HarmonInstruments/thelio-io-hardware/pcb-thelio-io/thelio-io.kicad_sch

## KiCad design pcb-thelio-io/thelio-io.kicad_sch (2023-07-17)

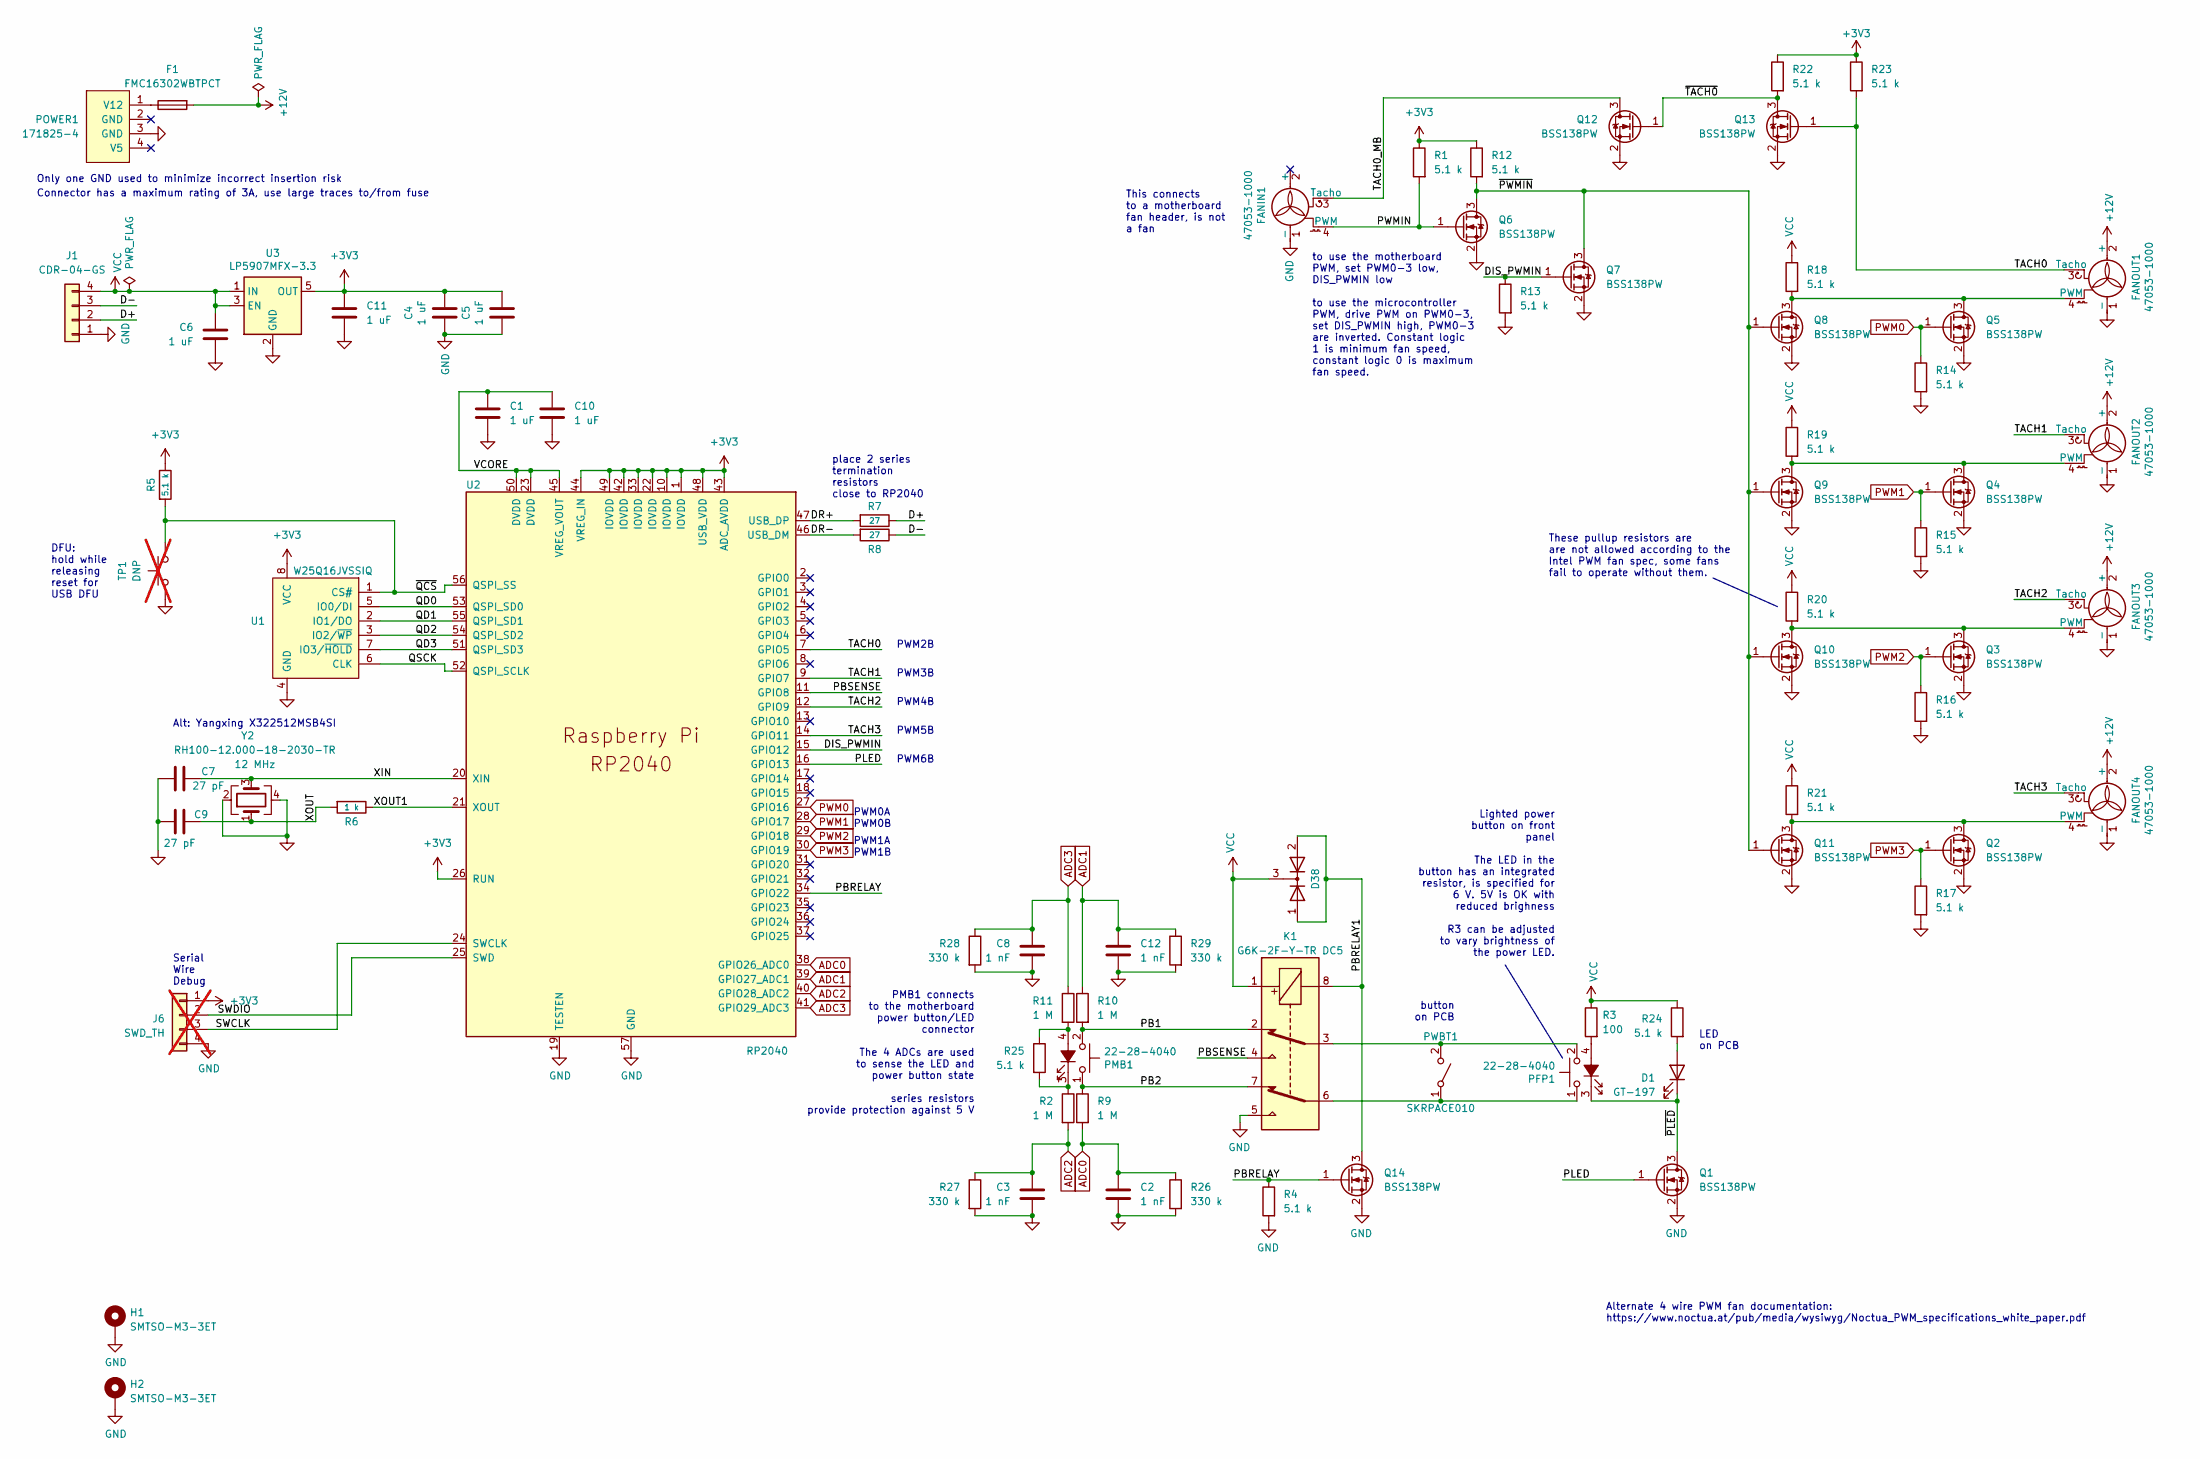
[picture p1: schematic thelio-io.kicad_sch]

Parts:
C1, C4, C5, C6, C10, C11: 1 uF; C_0402_1005Metric
C2, C3, C8, C12: 1 nF; C_0402_1005Metric
C7, C9: 27 pF; C_0402_1005Metric
D1: GT-197; LED_0603_1608Metric
D38: BAV70,215; SOT-23
F1: FMC16302WBTPCT; Fuse_0603_1608Metric
FANIN1: 47053-1000; FanPinHeader_1x04_P2.54mm_Vertical
FANOUT1, FANOUT2, FANOUT3, FANOUT4: 47053-1000; FanPinHeader_1x04_P2.54mm_Vertical
H1, H2: SMTSO-M3-3ET; SMTSO-M3-3
J1: CDR-04-GS; Molex_SL_171971-0004_1x04_P2.54mm_Vertical
J6: SWD_TH; PinHeader_1x04_P2.54mm_Vertical; not fitted
K1: G6K-2F-Y-TR DC5; Relay_DPDT_Omron_G6K-2F-Y
PFP1: 22-28-4040; PinHeader_1x04_P2.54mm_Vertical
PMB1: 22-28-4040; PinHeader_1x04_P2.54mm_Vertical
POWER1: 171825-4; ATA_FLOPPY_POWER_4
PWBT1: SKRPACE010; SW_SPST_PTS810
Q1, Q2, Q3, Q4, Q5, Q6, Q7, Q8, Q9, Q10, Q11, Q12, Q13, Q14: BSS138PW; SOT-323_SC-70
R1, R4, R5, R12, R13, R14, R15, R16, R17, R18, R19, R20, R21, R22, R23, R24, R25: 5.1 k; R_0402_1005Metric
R2, R9, R10, R11: 1 M; R_0402_1005Metric
R3: 100; R_0603_1608Metric
R6: 1 k; R_0402_1005Metric
R7, R8: 27; R_0402_1005Metric
R26, R27, R28, R29: 330 k; R_0402_1005Metric
TP1: DNP; TestPoint_2Pads_Pitch2.54mm_Drill0.8mm; not fitted
U1: W25Q16JVSSIQ; SOIC-8_5.23x5.23mm_P1.27mm
U2: RP2040; QFN-56-RP2040
U3: LP5907MFX-3.3; SOT-23-5
Y2: RH100-12.000-18-2030-TR; Oscillator_SMD_SeikoEpson_SG8002CE-4Pin_3.2x2.5mm

Connections:
+3V3: C4.1, C5.1, C11.2, J6.1, R1.1, R5.1, R12.1, R22.1, R23.1, U1.8 (VCC), U2.1 (IOVDD), U2.10 (IOVDD), U2.22 (IOVDD), U2.26 (RUN), U2.33 (IOVDD), U2.42 (IOVDD), U2.43 (ADC_AVDD), U2.44 (VREG_IN), U2.48 (USB_VDD), U2.49 (IOVDD), U3.5 (OUT)
+12V: F1.2, FANOUT1.2 (+), FANOUT2.2 (+), FANOUT3.2 (+), FANOUT4.2 (+)
ADC0: C2.2, R9.2, R26.1, U2.38 (GPIO26_ADC0)
ADC1: C12.2, R10.1, R29.1, U2.39 (GPIO27_ADC1)
ADC2: C3.2, R2.2, R27.1, U2.40 (GPIO28_ADC2)
ADC3: C8.2, R11.1, R28.1, U2.41 (GPIO29_ADC3)
D+: J1.2, R7.1
D-: J1.3, R8.1
DIS_PWMIN: Q7.1 (G), R13.1, U2.15 (GPIO12)
DR+: R7.2, U2.47 (USB_DP)
DR-: R8.2, U2.46 (USB_DM)
GND: C4.2, C5.2, FANIN1.1 (-), FANOUT1.1 (-), FANOUT2.1 (-), FANOUT3.1 (-), FANOUT4.1 (-), H1.1, H2.1, J1.1, J6.4, K1.5, POWER1.3 (GND), Q1.2 (S), Q2.2 (S), Q3.2 (S), Q4.2 (S), Q5.2 (S), Q6.2 (S), Q7.2 (S), Q8.2 (S), Q9.2 (S), Q10.2 (S), Q11.2 (S), Q12.2 (S), Q13.2 (S), Q14.2 (S), R4.2, R13.2, R14.2, R15.2, R16.2, R17.2, U2.19 (TESTEN), U2.57 (GND)
unnamed: D1.2 (A), R24.2
unnamed: F1.1, POWER1.1 (V12)
unnamed: FANOUT1.4 (PWM), Q5.3 (D), Q8.3 (D), R18.2
unnamed: FANOUT2.4 (PWM), Q4.3 (D), Q9.3 (D), R19.2
unnamed: FANOUT3.4 (PWM), Q3.3 (D), Q10.3 (D), R20.2
unnamed: FANOUT4.4 (PWM), Q2.3 (D), Q11.3 (D), R21.2
unnamed: K1.3, PFP1.2, PWBT1.2 (B)
unnamed: K1.6, PFP1.1, PWBT1.1 (A)
unnamed: PFP1.4 (A), R3.2
unnamed: PMB1.3 (K), R2.1, R25.2
unnamed: PMB1.4 (A), R11.2, R25.1
PB1: K1.2, PMB1.2, R10.2
PB2: K1.7, PMB1.1, R9.1
PBRELAY: Q14.1 (G), R4.1, U2.34 (GPIO22)
PBRELAY1: D38.1 (A), D38.2 (A), K1.8, Q14.3 (D)
PBSENSE: K1.4, U2.11 (GPIO8)
PLED: Q1.1 (G), U2.16 (GPIO13)
PWM0: Q5.1 (G), R14.1, U2.27 (GPIO16)
PWM1: Q4.1 (G), R15.1, U2.28 (GPIO17)
PWM2: Q3.1 (G), R16.1, U2.29 (GPIO18)
PWM3: Q2.1 (G), R17.1, U2.30 (GPIO19)
PWMIN: FANIN1.4 (PWM), Q6.1 (G), R1.2
QD0: U1.5 (IO0/DI), U2.53 (QSPI_SD0)
QD1: U1.2 (IO1/DO), U2.55 (QSPI_SD1)
QD2: U1.3 (IO2/~WP), U2.54 (QSPI_SD2)
QD3: U1.7 (IO3/~HOLD), U2.51 (QSPI_SD3)
QSCK: U1.6 (CLK), U2.52 (QSPI_SCLK)
SWCLK: J6.3, U2.24 (SWCLK)
SWDIO: J6.2, U2.25 (SWD)
TACH0: FANOUT1.3 (Tacho), Q13.1 (G), R23.2, U2.7 (GPIO5)
TACH0_MB: FANIN1.3 (Tacho), Q12.3 (D)
TACH1: FANOUT2.3 (Tacho), U2.9 (GPIO7)
TACH2: FANOUT3.3 (Tacho), U2.12 (GPIO9)
TACH3: FANOUT4.3 (Tacho), U2.14 (GPIO11)
VCC: C6.1, D38.3 (K), J1.4, K1.1, R3.1, R18.1, R19.1, R20.1, R21.1, R24.1, U3.1 (IN), U3.3 (EN)
VCORE: C1.2, C10.2, U2.23 (DVDD), U2.45 (VREG_VOUT), U2.50 (DVDD)
XIN: C7.1, U2.20 (XIN), Y2.3
XOUT: C9.1, R6.2, Y2.1
XOUT1: R6.1, U2.21 (XOUT)
ground: C1.1, C2.1, C3.1, C6.2, C7.2, C8.1, C9.2, C10.1, C11.1, C12.1, R26.2, R27.2, R28.2, R29.2, TP1.1, U1.4 (GND), U3.2 (GND), Y2.2, Y2.4
~PLED: D1.1 (K), PFP1.3 (K), Q1.3 (D)
~PWMIN: Q6.3 (D), Q7.3 (D), Q8.1 (G), Q9.1 (G), Q10.1 (G), Q11.1 (G), R12.2
~QCS: R5.2, TP1.2, U1.1 (CS#), U2.56 (QSPI_SS)
~TACH0: Q12.1 (G), Q13.3 (D), R22.2

Notes on the sheet:
Only one GND used to minimize incorrect insertion risk
button on PCB
PWM3B
This connects to a motherboard fan header, is not a fan
Connector has a maximum rating of 3A, use large traces to/from fuse
DFU: hold while releasing reset for USB DFU
Serial Wire Debug
Alt: Yangxing X322512MSB4SI
Alternate 4 wire PWM fan documentation: https://www.noctua.at/pub/media/wysiwyg/Noctua_PWM_specifications_white_paper.pdf
place 2 series termination resistors close to RP2040
PWM1A PWM1B
Lighted power button on front panel The LED in the button has an integrated resistor, is specified for 6 V. 5V is OK with reduced brighness R3 can be adjusted to vary brightness of the power LED.
PWM4B
PWM5B
LED on PCB
These pullup resistors are are not allowed according to the Intel PWM fan spec, some fans fail to operate without them.
PMB1 connects to the motherboard power button/LED connector The 4 ADCs are used to sense the LED and power button state series resistors provide protection against 5 V
to use the motherboard PWM, set PWM0-3 low, DIS_PWMIN low to use the microcontroller PWM, drive PWM on PWM0-3, set DIS_PWMIN high, PWM0-3 are inverted. Constant logic 1 is minimum fan speed, constant logic 0 is maximum fan speed.
PWM0A PWM0B
PWM6B
PWM2B
